Irham-Dipra/Automated-Maze-Solver_CSE-316/Assets/project_specs.md

Project Proposal Guidelines

The proposal presentation should include the following sections:

1. Motivation

* Clearly describe the problem your project will solve.
* Explain why the problem is important.
* State why your group selected this project.
* List the main objectives of the project.

2. Equipment

Provide a list of the required:

* Hardware components
* Software or development tools

Briefly mention the purpose of each major component.

3. System Design

* Provide a clear block diagram showing how the components are connected.
* Briefly explain the role of each component.
* Mention the important ATmega32 pins or interfaces to be used.

4. Role of the ATmega32

Clearly explain:

* What tasks the ATmega32 will perform.
* Which features will be used, such as GPIO, ADC, timers, PWM, interrupts, UART, SPI, or I²C.

The ATmega32 must perform a significant role in the project.

5. Implementation Plan

* Describe the expected outcome of the project.
* Divide the work into two development stages - project update 1 and final.
* Mention the main milestones and dependencies.
* Specify the responsibilities of each group member.

6. Use of Other Controllers — Optional

If another controller, such as an ESP32, Arduino, or Raspberry Pi, is used, explain:

* Why it is required.
* What tasks it will perform.
* How it will communicate with the ATmega32.

7. Testing and Success Criteria

* Explain how the system will be tested.
* Define measurable criteria for project success.
* Separate the essential features from optional features.

8. Challenges and Future Scope

* Identify possible technical or hardware-related challenges.
* Briefly discuss possible future improvements.
