Irham-Dipra/Automated-Maze-Solver_CSE-316/Assets/connections.md

# Connections

### Logic Power (Breadboard & MCUs)
*   Battery Pack 1 (Logic) -> Buck Converter IN
*   Buck Converter (5V) OUT+ -> Breadboard Power 1 & 2 (5V Rail)
*   Buck Converter (5V) OUT- -> Breadboard Gnd 1 & 2 (Common Gnd)

### Motor Power (High Current)
*   Battery Pack 2 (7.4V) positive -> Rocker Switch (Terminal 1)
*   Rocker Switch (Terminal 2) -> Motor drive 12V
*   Battery Pack 2 (7.4V) negative -> Motor drive GND
*   **CRITICAL:** Motor drive GND -> Breadboard Gnd 2 (Common ground required for PWM logic!)
*   *Note: Motor Driver 5V output is NO LONGER connected to the breadboard.*

## Capacitors (Noise Filtering)
*   1000µF Capacitor -> Across vin and GND of ESP32
*   100nF Capacitor -> Across ESP32 VIN and GND
*   100nF Capacitor -> Across ATmega32 VCC and GND

## Motor Driver Connections

*   Out1 - Left Motor top
*   Out2 - Left Motor bottom
*   Out3 - Right Motor top
*   Out4 - Right Motor bottom

*   IN1 - Atmega PB0 (1)
*   IN2 - Atmega PB1 (2)
*   IN3 - Atmega PB2 (3)
*   IN4 - Atmega PB4 (5)

*   ENA - Atmega PD5 (19)
*   ENB - Atmega PD4 (18)

## Atmega connections

*   VCC (Pin 10) - power 1
*   GND (Pin 11) - Gnd 1

*   AVCC (Pin 30) - power 2
*   GND  (Pin 31) - Gnd 2

## ESP

*   VIN - Power 2
*   ESP Gnd 1 - Gnd 1

## Logic Level Shifter (UART Bridge & 3.3V Sensor Power)

*   HV - Power 1 (ATmega 5V)
*   LV - ESP32 3V3 Pin (Creates the 3.3V Breadboard rail that powers all sensors)
*   GND (both) - Gnd 1 / Gnd 2
*   LV1 - ESP32 TX2 (Pin 24)
*   HV1 - ATmega RXD (PD0 / Pin 14)

## I2C Sensors (3x VL53L0X ToF & MPU6050 Gyro)

### Power (Shared by all sensors)
*   VIN / VCC - 3.3V Breadboard rail (from LV pin of Level Shifter / ESP32 3V3)
*   GND - Common Ground (Breadboard Gnd)

### I2C Bus (Shared parallel connection for all sensors)
*   SDA - ESP32 Pin 21
*   SCL - ESP32 Pin 22

### ToF XSHUT (Unique pin for each ToF sensor)
*   Front ToF XSHUT - ESP32 Pin 19
*   Left ToF XSHUT - ESP32 Pin 18
*   Right ToF XSHUT - ESP32 Pin 4
