Irham-Dipra/Automated-Maze-Solver_CSE-316/project proposal/presentation.pdf

## Automated Maze Solver


CSE 316: Microcontroller and Microprocessor Sessional

Group members:
Irham Dipra (2205068)
Priyanjan Das Anabil (2205079) Aroni Ananya (2205087)

Motivation

Motivation

## The project solves the challenge of an autonomous

## robot entering an unknown maze without simply

following a pre-drawn line.

Motivation

## It demonstrates the physical application of

## embedded algorithms, spatial mapping, and graph

traversal over basic reactive control.

Motivation

## This project leverages the group’s strong software foundation in algorithms (like BFS and Flood Fill)

## and data structures, applying them to a complex

physical constraint.

Motivation

## The robot must map the maze, remember visited

## cells, calculate the shortest exit path, and return to

the start.

Equipments & Roles


## ATmega32 Dev Board:

Main low-level microcontroller for hardware interrupts and motor driving.

Equipments & Roles


## ESP32 DevKit V1:

Coprocessor responsible for processing sensor arrays and executing pathfinding algorithms.

Equipments & Roles


## L298N Motor Driver:

Controls the voltage and direction of the chassis motors based on microcontroller signals.

Equipments & Roles


## 2WD Robot Chassis Kit:

Provides the physical movement platform, critically requiring included wheel encoder discs.

Equipments & Roles


## 3x VL53L0X ToF Sensors:

High-precision time-of-flight sensors to detect walls on the front, left, and right sides.

Equipments & Roles


## 18650 Batteries &

## Regulators:

Provides reliable portable power for the motors and distinct logic levels for the microcontrollers.

System Design

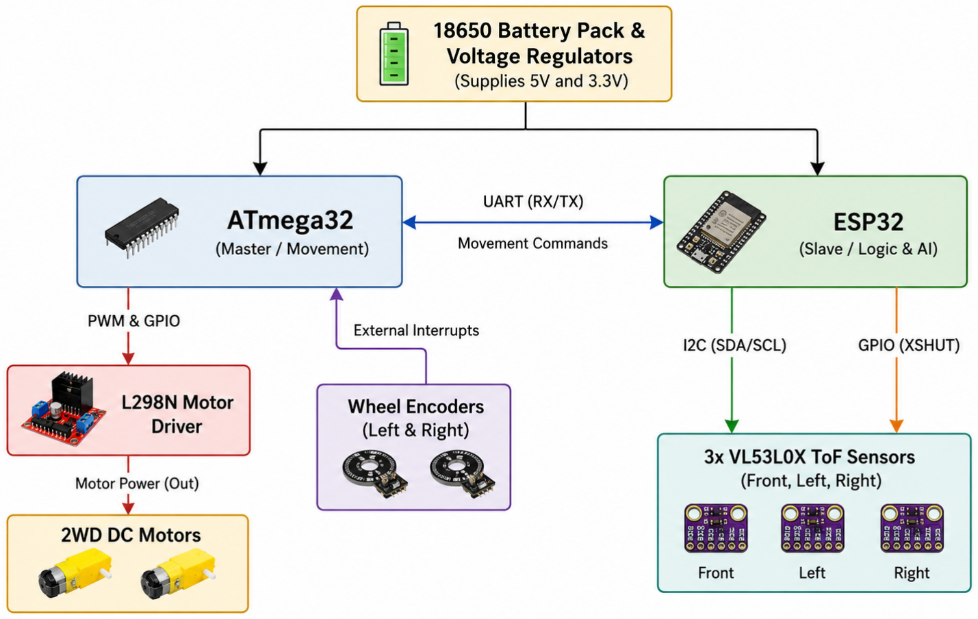
[picture p10: figure]

The system uses a master-slave configuration between the ATmega32 and the ESP32.

System Design

The ATmega32 is wired directly to the L298N motor driver and reads the wheel encoders.

System Design

The ESP32 interfaces with the three VL53L0X Time-of-Flight sensors via the I2C bus.

System Design

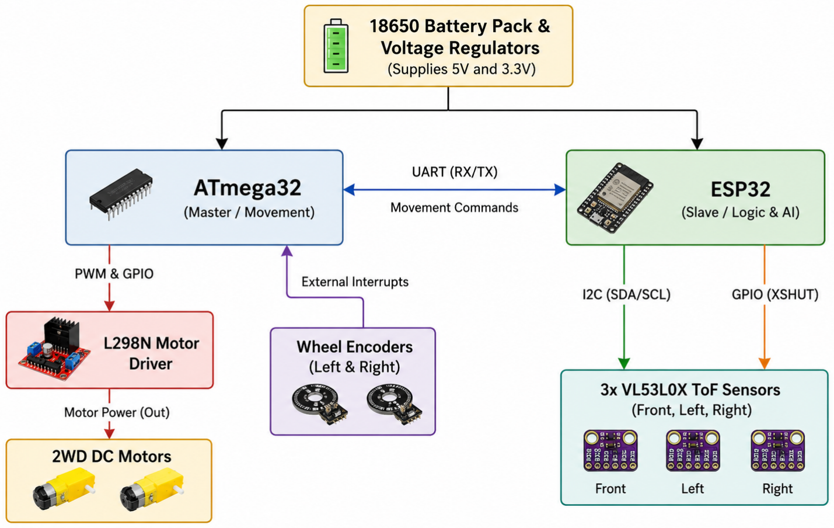
[picture p11: figure]

The ESP32 calculates movement logic and sends high-level commands (e.g., ”Move Forward 1 cell”) to the ATmega32 over a UART serial connection.

System Design

Important ATmega32 Interfaces Used:

UART (RX/TX Pins): Used to establish serial communication with the ESP32 to receive navigation commands.

System Design

Important ATmega32 Interfaces Used:

External Interrupt Pins (INT0 / INT1): Used to read the rapid pulse signals generated by the left and right wheel encoders to track distance.

System Design

Important ATmega32 Interfaces Used:

PWM Channels: Used to send variable voltage signals to the L298N driver, allowing for dynamic motor speed control via a PID algorithm.

System Design

Important ATmega32 Interfaces Used:

Standard GPIO Pins: Used to send basic HIGH/LOW logic to the L298N driver to control the forward and reverse direction of the motors.

Role of the ATmega32

- Primary Tasks:

Role of the ATmega32

- Primary Tasks:
- Dedicated real-time motion controller (translates ESP32 commands to motor timings).

Role of the ATmega32

- Primary Tasks:
- Dedicated real-time motion controller (translates ESP32 commands to motor timings).
- Executes continuous PID algorithm for straight driving and exact 90◦
turns.

Role of the ATmega32

- Primary Tasks:
- Dedicated real-time motion controller (translates ESP32 commands to motor timings).
- Executes continuous PID algorithm for straight driving and exact 90◦
turns.
- Hardware Features Utilized:

Role of the ATmega32

- Primary Tasks:
- Dedicated real-time motion controller (translates ESP32 commands to motor timings).
- Executes continuous PID algorithm for straight driving and exact 90◦
turns.
- Hardware Features Utilized:
- INT0/INT1: Read encoders for real-time distance tracking.

Role of the ATmega32

- Primary Tasks:
- Dedicated real-time motion controller (translates ESP32 commands to motor timings).
- Executes continuous PID algorithm for straight driving and exact 90◦
turns.
- Hardware Features Utilized:
- INT0/INT1: Read encoders for real-time distance tracking.
- Timers & PWM: Dynamic motor speed adjustments via PID.

Role of the ATmega32

- Primary Tasks:
- Dedicated real-time motion controller (translates ESP32 commands to motor timings).
- Executes continuous PID algorithm for straight driving and exact 90◦
turns.
- Hardware Features Utilized:
- INT0/INT1: Read encoders for real-time distance tracking.
- Timers & PWM: Dynamic motor speed adjustments via PID.
- UART & GPIO: Receive navigation commands and dictate

motor directions.

Use of Other Controllers (ESP32)

- Memory Constraint: The ATmega32 only has 2KB of

SRAM, which severely limits its ability to store complex maze arrays while handling heavy real-time motor control.

Use of Other Controllers (ESP32)

- Memory Constraint: The ATmega32 only has 2KB of

SRAM, which severely limits its ability to store complex maze arrays while handling heavy real-time motor control.
- Tasks: The ESP32 handles the heavy lifting of the Flood Fill

algorithm, tracks the state of the 256 cells, and manages the dynamic addressing sequence for the I2C sensors.

Use of Other Controllers (ESP32)

- Memory Constraint: The ATmega32 only has 2KB of

SRAM, which severely limits its ability to store complex maze arrays while handling heavy real-time motor control.
- Tasks: The ESP32 handles the heavy lifting of the Flood Fill

algorithm, tracks the state of the 256 cells, and manages the dynamic addressing sequence for the I2C sensors.
- Communication: It acts as the ”brain,” sending simplified

directional commands to the ATmega32 over UART.

Implementation Plan: Expected Outcome

- Expected Outcome: A fully autonomous robot capable of

navigating a 16 × 16 maze grid, mapping dead ends, and calculating the fastest route.

Implementation Plan: Project Updates

- Project Update 1 (Weeks 1-2):

Implementation Plan: Project Updates

- Project Update 1 (Weeks 1-2):
- Complete chassis assembly.

Implementation Plan: Project Updates

- Project Update 1 (Weeks 1-2):
- Complete chassis assembly.
- Establish PC simulation of the Flood Fill algorithm.

Implementation Plan: Project Updates

- Project Update 1 (Weeks 1-2):
- Complete chassis assembly.
- Establish PC simulation of the Flood Fill algorithm.
- Finalize the ATmega32 PID controller so the robot can drive in a perfectly straight line for 1 meter.

Implementation Plan: Project Updates

- Project Update 1 (Weeks 1-2):
- Complete chassis assembly.
- Establish PC simulation of the Flood Fill algorithm.
- Finalize the ATmega32 PID controller so the robot can drive in a perfectly straight line for 1 meter.
- Project Update 2 (Weeks 3-5):

Implementation Plan: Project Updates

- Project Update 1 (Weeks 1-2):
- Complete chassis assembly.
- Establish PC simulation of the Flood Fill algorithm.
- Finalize the ATmega32 PID controller so the robot can drive in a perfectly straight line for 1 meter.
- Project Update 2 (Weeks 3-5):
- Integrate the ToF sensors with the ESP32.

Implementation Plan: Project Updates

- Project Update 1 (Weeks 1-2):
- Complete chassis assembly.
- Establish PC simulation of the Flood Fill algorithm.
- Finalize the ATmega32 PID controller so the robot can drive in a perfectly straight line for 1 meter.
- Project Update 2 (Weeks 3-5):
- Integrate the ToF sensors with the ESP32.
- Merge the mapping logic with the movement logic.

Implementation Plan: Project Updates

- Project Update 1 (Weeks 1-2):
- Complete chassis assembly.
- Establish PC simulation of the Flood Fill algorithm.
- Finalize the ATmega32 PID controller so the robot can drive in a perfectly straight line for 1 meter.
- Project Update 2 (Weeks 3-5):
- Integrate the ToF sensors with the ESP32.
- Merge the mapping logic with the movement logic.
- Finalize edge-case tuning for wall-drift correction.

Testing and Success Criteria

System Testing Methodology

- Phased Approach: System tested in 4 phases to isolate

hardware vs. algorithmic bugs.

Testing and Success Criteria

System Testing Methodology

- Phased Approach: System tested in 4 phases to isolate

hardware vs. algorithmic bugs.
- Phase 1 (Locomotion & PID): Test perfectly straight 1m driving and exact 90◦
turns using encoder counts.

Testing and Success Criteria

System Testing Methodology

- Phased Approach: System tested in 4 phases to isolate

hardware vs. algorithmic bugs.
- Phase 1 (Locomotion & PID): Test perfectly straight 1m driving and exact 90◦
turns using encoder counts.
- Phase 2 (Sensor & I2C Calibration): Verify XSHUT

addressing to prevent I2C conflicts and calibrate ToF distances.

Testing and Success Criteria

System Testing Methodology

- Phased Approach: System tested in 4 phases to isolate

hardware vs. algorithmic bugs.
- Phase 1 (Locomotion & PID): Test perfectly straight 1m driving and exact 90◦
turns using encoder counts.
- Phase 2 (Sensor & I2C Calibration): Verify XSHUT

addressing to prevent I2C conflicts and calibrate ToF distances.
- Phase 3 (Algorithm Simulation): Test Flood Fill algorithm

on a PC simulation (virtual 16 × 16 grid) before flashing the ESP32.

Testing and Success Criteria

System Testing Methodology

- Phased Approach: System tested in 4 phases to isolate

hardware vs. algorithmic bugs.
- Phase 1 (Locomotion & PID): Test perfectly straight 1m driving and exact 90◦
turns using encoder counts.
- Phase 2 (Sensor & I2C Calibration): Verify XSHUT

addressing to prevent I2C conflicts and calibrate ToF distances.
- Phase 3 (Algorithm Simulation): Test Flood Fill algorithm

on a PC simulation (virtual 16 × 16 grid) before flashing the ESP32.
- Phase 4 (Full Integration): Test hardware/software

synchronization in scaled-down physical mazes (e.g., 4 × 4,
8 × 8). | 9

Testing and Success Criteria

Measurable Criteria for Project Success

- Metric 1: PID Synchronization Error (EPID)

Testing and Success Criteria

Measurable Criteria for Project Success

- Metric 1: PID Synchronization Error (EPID)
- Ensures motors spin at identical rates without drifting.

Testing and Success Criteria

Measurable Criteria for Project Success

- Metric 1: PID Synchronization Error (EPID)
- Ensures motors spin at identical rates without drifting.
- Formula: EPID = |Cleft − Cright| (where C = encoder pulse counts).

Testing and Success Criteria

Measurable Criteria for Project Success

- Metric 1: PID Synchronization Error (EPID)
- Ensures motors spin at identical rates without drifting.
- Formula: EPID = |Cleft − Cright| (where C = encoder pulse counts).
- Success: Steady-state error must approach zero during a

straight-line traversal.

Testing and Success Criteria

Measurable Criteria for Project Success

- Metric 1: PID Synchronization Error (EPID)
- Ensures motors spin at identical rates without drifting.
- Formula: EPID = |Cleft − Cright| (where C = encoder pulse counts).
- Success: Steady-state error must approach zero during a

straight-line traversal.
- Metric 2: Algorithmic Path Efficiency (ηpath)

Testing and Success Criteria

Measurable Criteria for Project Success

- Metric 1: PID Synchronization Error (EPID)
- Ensures motors spin at identical rates without drifting.
- Formula: EPID = |Cleft − Cright| (where C = encoder pulse counts).
- Success: Steady-state error must approach zero during a

straight-line traversal.
- Metric 2: Algorithmic Path Efficiency (ηpath)
- Evaluates optimal path calculation after mapping.

Testing and Success Criteria

Measurable Criteria for Project Success

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

straight-line traversal.
- Metric 2: Algorithmic Path Efficiency (ηpath)
- Evaluates optimal path calculation after mapping.
- Formula: ηpath =

Soptimal

Straversed

(Optimal cells vs. actual cells traversed).

Testing and Success Criteria

Measurable Criteria for Project Success

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

straight-line traversal.
- Metric 2: Algorithmic Path Efficiency (ηpath)
- Evaluates optimal path calculation after mapping.
- Formula: ηpath =

Soptimal

Straversed

(Optimal cells vs. actual cells traversed).
- Success: Achieving ηpath = 1, proving Flood Fill found the

absolute shortest path.

Testing and Success Criteria

Separation of Features

- Essential Features (MVP):

Testing and Success Criteria

Separation of Features

- Essential Features (MVP):
- Maintain accurate digital (X, Y ) coordinates and heading in

memory.

Testing and Success Criteria

Separation of Features

- Essential Features (MVP):
- Maintain accurate digital (X, Y ) coordinates and heading in

memory.
- Autonomously map the maze and find the center in a single

pass.

Testing and Success Criteria

Separation of Features

- Essential Features (MVP):
- Maintain accurate digital (X, Y ) coordinates and heading in

memory.
- Autonomously map the maze and find the center in a single

pass.
- Execute stable continuous PID motor control to navigate

without crashing.

Testing and Success Criteria

Separation of Features

- Essential Features (MVP):
- Maintain accurate digital (X, Y ) coordinates and heading in

memory.
- Autonomously map the maze and find the center in a single

pass.
- Execute stable continuous PID motor control to navigate

without crashing.
- Optional Features (Stretch Goals):

Testing and Success Criteria

Separation of Features

- Essential Features (MVP):
- Maintain accurate digital (X, Y ) coordinates and heading in

memory.
- Autonomously map the maze and find the center in a single

pass.
- Execute stable continuous PID motor control to navigate

without crashing.
- Optional Features (Stretch Goals):
- The Speed Run: Return to the start and execute a

high-speed run through the optimal path.

Testing and Success Criteria

Separation of Features

- Essential Features (MVP):
- Maintain accurate digital (X, Y ) coordinates and heading in

memory.
- Autonomously map the maze and find the center in a single

pass.
- Execute stable continuous PID motor control to navigate

without crashing.
- Optional Features (Stretch Goals):
- The Speed Run: Return to the start and execute a

high-speed run through the optimal path.
- Live Wi-Fi Telemetry: Broadcast the internal maze map in

real-time to a laptop dashboard.

Challenges and Future Scope

Technical and Hardware-Related Challenges

- Wheel Slip & Trajectory Drift:

Challenges and Future Scope

Technical and Hardware-Related Challenges

- Wheel Slip & Trajectory Drift:
- Physical motors never spin at perfectly identical speeds.

Challenges and Future Scope

Technical and Hardware-Related Challenges

- Wheel Slip & Trajectory Drift:
- Physical motors never spin at perfectly identical speeds.
- Solution: Highly tuned PID control using wheel encoders to constantly correct drift.

Challenges and Future Scope

Technical and Hardware-Related Challenges

- Wheel Slip & Trajectory Drift:
- Physical motors never spin at perfectly identical speeds.
- Solution: Highly tuned PID control using wheel encoders to constantly correct drift.
- I2C Address Conflicts:

Challenges and Future Scope

Technical and Hardware-Related Challenges

- Wheel Slip & Trajectory Drift:
- Physical motors never spin at perfectly identical speeds.
- Solution: Highly tuned PID control using wheel encoders to constantly correct drift.
- I2C Address Conflicts:
- All three VL53L0X sensors share the same default I2C address.

Challenges and Future Scope

Technical and Hardware-Related Challenges

- Wheel Slip & Trajectory Drift:
- Physical motors never spin at perfectly identical speeds.
- Solution: Highly tuned PID control using wheel encoders to constantly correct drift.
- I2C Address Conflicts:
- All three VL53L0X sensors share the same default I2C address.
- Solution: Sequentially wake sensors via XSHUT pins and

dynamically assign unique addresses.

Challenges and Future Scope

Technical and Hardware-Related Challenges

- Wheel Slip & Trajectory Drift:
- Physical motors never spin at perfectly identical speeds.
- Solution: Highly tuned PID control using wheel encoders to constantly correct drift.
- I2C Address Conflicts:
- All three VL53L0X sensors share the same default I2C address.
- Solution: Sequentially wake sensors via XSHUT pins and

dynamically assign unique addresses.
- ATmega32 Memory Limits (2KB SRAM):

Challenges and Future Scope

Technical and Hardware-Related Challenges

- Wheel Slip & Trajectory Drift:
- Physical motors never spin at perfectly identical speeds.
- Solution: Highly tuned PID control using wheel encoders to constantly correct drift.
- I2C Address Conflicts:
- All three VL53L0X sensors share the same default I2C address.
- Solution: Sequentially wake sensors via XSHUT pins and

dynamically assign unique addresses.
- ATmega32 Memory Limits (2KB SRAM):
- High risk of exhausting memory when storing maze states and

processing interrupts.

Challenges and Future Scope

Technical and Hardware-Related Challenges

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

dynamically assign unique addresses.
- ATmega32 Memory Limits (2KB SRAM):
- High risk of exhausting memory when storing maze states and

processing interrupts.
- Solution: Use efficient bitwise operations and offload Flood Fill logic to the ESP32.

Challenges and Future Scope

Future Scope and Improvements

- Live Wi-Fi Telemetry (Dashboard):

Challenges and Future Scope

Future Scope and Improvements

- Live Wi-Fi Telemetry (Dashboard):
- Broadcast the ESP32’s internal maze map over Wi-Fi.

Challenges and Future Scope

Future Scope and Improvements

- Live Wi-Fi Telemetry (Dashboard):
- Broadcast the ESP32’s internal maze map over Wi-Fi.
- Visualize robot coordinates and walls in real-time on a React/Node.js frontend.

Challenges and Future Scope

Future Scope and Improvements

- Live Wi-Fi Telemetry (Dashboard):
- Broadcast the ESP32’s internal maze map over Wi-Fi.
- Visualize robot coordinates and walls in real-time on a React/Node.js frontend.
- The Optimal Speed Run:

Challenges and Future Scope

Future Scope and Improvements

- Live Wi-Fi Telemetry (Dashboard):
- Broadcast the ESP32’s internal maze map over Wi-Fi.
- Visualize robot coordinates and walls in real-time on a React/Node.js frontend.
- The Optimal Speed Run:
- Expand the software to a complete multi-pass solver.

Challenges and Future Scope

Future Scope and Improvements

- Live Wi-Fi Telemetry (Dashboard):
- Broadcast the ESP32’s internal maze map over Wi-Fi.
- Visualize robot coordinates and walls in real-time on a React/Node.js frontend.
- The Optimal Speed Run:
- Expand the software to a complete multi-pass solver.
- After mapping, return to start and execute a high-speed run

through the calculated shortest route.

Challenges and Future Scope

Future Scope and Improvements

- Live Wi-Fi Telemetry (Dashboard):
- Broadcast the ESP32’s internal maze map over Wi-Fi.
- Visualize robot coordinates and walls in real-time on a React/Node.js frontend.
- The Optimal Speed Run:
- Expand the software to a complete multi-pass solver.
- After mapping, return to start and execute a high-speed run

through the calculated shortest route.
- Sensor Fusion (IMU Integration):

Challenges and Future Scope

Future Scope and Improvements

- Live Wi-Fi Telemetry (Dashboard):
- Broadcast the ESP32’s internal maze map over Wi-Fi.
- Visualize robot coordinates and walls in real-time on a React/Node.js frontend.
- The Optimal Speed Run:
- Expand the software to a complete multi-pass solver.
- After mapping, return to start and execute a high-speed run

through the calculated shortest route.
- Sensor Fusion (IMU Integration):
- Integrate an MPU6050 (Accelerometer & Gyroscope).

Challenges and Future Scope

Future Scope and Improvements

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

through the calculated shortest route.
- Sensor Fusion (IMU Integration):
- Integrate an MPU6050 (Accelerometer & Gyroscope).
- Fuse gyro data with wheel encoders for flawless straight headings and exactly 90◦
turns.
