Irham-Dipra/Automated-Maze-Solver_CSE-316/bluetooth_logs/test4.txt

07:37:05.783 Connecting to Maze_Calibrator ...
07:37:07.105 Connected
07:37:08.311 
07:37:08.311 === HARDWARE CALIBRATION MENU ===
07:37:08.320 Commands:
07:37:08.320   BL:150  -> Base Left Speed
07:37:08.320   BR:150  -> Base Right Speed
07:37:08.320   TR:400  -> Turn Right Delay
07:37:08.320   TL:400  -> Turn Left Delay
07:37:08.320   TU:800  -> U-Turn Delay
07:37:08.320   FD:260  -> Front Brake Distance
07:37:08.320   START   -> Begin driving
07:37:08.320   STOP    -> Halt the car
07:37:08.320 =================================
07:37:08.320 
07:37:08.320 Current: BL=128 | BR=145 | TR=390 | TL=390 | TU=780 | FD=260
07:37:23.512 BL:255
07:37:23.603 
07:37:23.603 Current: BL=255 | BR=145 | TR=390 | TL=390 | TU=780 | FD=260
07:37:31.963 BR:80
07:37:32.199 
07:37:32.199 Current: BL=255 | BR=80 | TR=390 | TL=390 | TU=780 | FD=260
07:37:43.603 FD:280
07:37:48.060 FD:280
07:37:49.326 FD:280
07:37:53.836 START
07:37:53.895 
07:37:53.895 >>> STARTING BLIND CALIBRATION DRIVE <<<
07:37:54.035 SOFT START: Ramping up power to prevent Brown-Out Resets...
07:37:54.271 BLIND DRIVE: [F:8190 L:117 R:120]
07:37:54.440 BLIND DRIVE: [F:8190 L:98 R:189]
07:37:54.598 
07:37:54.598 CORNER DETECTED! [F:78 L:78 R:8190]
07:37:56.619 Blind Turning Right...
07:37:56.999 Turn complete! Check the physical angle!
07:37:59.541 SOFT START: Ramping up power to prevent Brown-Out Resets...
07:37:59.542 BLIND DRIVE: [F:8190 L:151 R:178]
07:37:59.667 BLIND DRIVE: [F:8190 L:143 R:116]
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
07:39:14.421 
07:39:14.421 CORNER DETECTED! [F:43 L:8190 R:8190]
07:39:16.174 STOP
07:39:16.255 Blind Turning Right...
07:39:16.649 Turn complete! Check the physical angle!
07:39:18.706 
07:39:18.706 >>> SYSTEM HALTED! You may now recalibrate. Send 'START' to resume. <<<
