Irham-Dipra/Automated-Maze-Solver_CSE-316/bluetooth_logs/test5.txt

IND DRIVE: [F:8190 L:117 R:120]
07:54:37.098 BLIND DRIVE: [F:8190 L:117 R:134]
07:54:37.274 BLIND DRIVE: [F:8190 L:117 R:125]
07:54:37.441 BLIND DRIVE: [F:8190 L:122 R:122]
07:54:37.606 BLIND DRIVE: [F:8190 L:137 R:105]
07:54:37.796 BLIND DRIVE: [F:8190 L:154 R:91]
07:54:37.957 BLIND DRIVE: [F:8190 L:177 R:75]
07:54:38.129 BLIND DRIVE: [F:8190 L:206 R:48]
07:54:38.408 BLIND DRIVE: [F:8190 L:8190 R:33]
07:54:38.492 BLIND DRIVE: [F:8190 L:8190 R:27]
07:54:38.648 BLIND DRIVE: [F:8190 L:8190 R:33]
07:54:38.827 BLIND DRIVE: [F:8190 L:8190 R:42]
07:54:38.994 BLIND DRIVE: [F:8190 L:237 R:8190]
07:54:39.157 BLIND DRIVE: [F:8190 L:232 R:19]
07:54:39.337 BLIND DRIVE: [F:8190 L:240 R:36]
07:54:39.503 
07:54:39.503 CORNER DETECTED! [F:148 L:239 R:33]
07:54:41.528 Blind U-Turn...
07:54:42.280 Turn complete! Check the physical angle!
07:54:44.470 
07:54:44.470 CORNER DETECTED! [F:84 L:265 R:49]
07:54:44.854 STOP
07:54:46.465 Blind Turning Left...
07:54:46.851 Turn complete! Check the physical angle!
07:54:48.923 
07:54:48.923 >>> SYSTEM HALTED! You may now recalibrate. Send 'START' to resume. <<<
07:55:03.677 BL:250
07:55:03.902 
07:55:03.902 Current: BL=250 | BR=10 | TR=390 | TL=390 | TU=780 | FD=360
07:55:07.244 START
07:55:07.305 
07:55:07.305 >>> RESUMING DRIVE WITH NEW CALIBRATION! <<<
07:55:07.420 SOFT START: Ramping up power to prevent Brown-Out Resets...
07:55:07.668 BLIND DRIVE: [F:8190 L:121 R:118]
07:55:07.939 BLIND DRIVE: [F:8190 L:115 R:134]
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
07:58:08.177 
07:58:08.177 CORNER DETECTED! [F:48 L:203 R:8190]
07:58:09.101 STOP
07:58:09.729 Blind Turning Right...
07:58:10.098 Turn complete! Check the physical angle!
07:58:11.518 STOP
07:58:12.158 
07:58:12.158 >>> SYSTEM HALTED! You may now recalibrate. Send 'START' to resume. <<<
