Irham-Dipra/Automated-Maze-Solver_CSE-316/bluetooth_logs/test6.txt

01:41:23.267 Connection lost
01:41:27.479 Connecting to Maze_Robot_Dipra ...
01:41:29.819 Connected
01:41:31.311 
01:41:31.311 === PHASE 3 (PID) CALIBRATION MENU ===
01:41:31.311   BL:180  -> Base Left Speed
01:41:31.311   BR:10   -> Base Right Speed
01:41:31.311   FD:260  -> Front Brake Distance
01:41:31.311   P:0.3   -> PID P-Gain
01:41:31.311   D:0.2   -> PID D-Gain
01:41:31.311   START   -> Begin driving
01:41:31.311   STOP    -> Halt the car (on the fly)
01:41:31.311 ======================================
01:41:31.311 
01:41:31.311 Current: BL=180 | BR=10 | TR=390 | TL=390 | TU=780 | FD=260 | P=0.20 | D=0.10 | I=0.00
01:41:42.482 BL:220
01:41:42.636 
01:41:42.636 Current: BL=220 | BR=10 | TR=390 | TL=390 | TU=780 | FD=260 | P=0.20 | D=0.10 | I=0.00
01:41:47.748 BL:220FD:300
01:41:47.932 
01:41:47.932 Current: BL=220 | BR=10 | TR=390 | TL=390 | TU=780 | FD=260 | P=0.20 | D=0.10 | I=0.00
01:41:54.122 FD:300
01:41:54.628 
01:41:54.628 Current: BL=220 | BR=10 | TR=390 | TL=390 | TU=780 | FD=300 | P=0.20 | D=0.10 | I=0.00
01:42:00.997 TR:350
01:42:40.638 P:1.5
01:42:40.733 
01:42:40.733 Current: BL=220 | BR=10 | TR=390 | TL=390 | TU=780 | FD=300 | P=1.50 | D=0.10 | I=0.00
01:42:45.822 START
01:42:46.007 
01:42:46.007 >>> STARTING PID MAZE SOLVER! <<<
01:42:46.166 PID -> Err:5 Adj:8 [L:84 R:7]
01:42:46.378 PID -> Err:0 Adj:0 [L:110 R:5]
01:42:46.497 PID -> Err:-24 Adj:-38 [L:153 R:0]
01:42:46.675 PID -> Err:-57 Adj:-88 [L:178 R:0]
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
01:43:25.022 PID -> Err:107 Adj:160 [L:60 R:170]
01:43:25.195 PID -> Err:104 Adj:155 [L:65 R:165]
01:43:25.276 STOP
01:43:25.353 PID -> Err:103 Adj:154 [L:66 R:164]
01:43:25.411 
01:43:25.411 >>> SYSTEM HALTED! You may now recalibrate. Send 'START' to resume. <<<
