Irham-Dipra/Automated-Maze-Solver_CSE-316/bluetooth_logs/test8.txt

96 PID -> Err:-32 Adj:-25 (Steering Left) [PWM_L:255 PWM_R:0]
02:53:24.652 PID -> Err:-31 Adj:-24 (Steering Left) [PWM_L:255 PWM_R:0]
02:53:24.824 PID -> Err:-31 Adj:-24 (Steering Left) [PWM_L:255 PWM_R:0]
02:53:25.006 PID -> Err:-32 Adj:-25 (Steering Left) [PWM_L:255 PWM_R:0]
02:53:25.186 PID -> Err:-30 Adj:-23 (Steering Left) [PWM_L:255 PWM_R:0]
02:53:25.347 PID -> Err:-32 Adj:-25 (Steering Left) [PWM_L:255 PWM_R:0]
02:53:25.538 PID -> Err:-32 Adj:-25 (Steering Left) [PWM_L:255 PWM_R:0]
02:53:27.269 PID -> Err:-31 Adj:-24 (Steering Left) [PWM_L:255 PWM_R:0]
02:53:27.269 PID -> Err:-31 Adj:-24 (Steering Left) [PWM_L:255 PWM_R:0]
02:53:27.272 PID -> Err:-31 Adj:-24 (Steering Left) [PWM_L:255 PWM_R:0]
02:53:27.277 PID -> Err:-30 Adj:-23 (Steering Left) [PWM_L:255 PWM_R:0]
02:53:27.282 PID -> Err:-32 Adj:-25 (Steering Left) [PWM_L:255 PWM_R:0]
02:53:27.287 PID -> Err:-34 Adj:-27 (Steering Left) [PWM_L:255 PWM_R:0]
02:53:27.317 PID -> Err:-31 Adj:-24 (Steering Left) [PWM_L:255 PWM_R:0]
02:53:27.320 PID -> Err:-33 Adj:-26 (Steering Left) [PWM_L:255 PWM_R:0]
02:53:27.320 PID -> Err:-30 Adj:-23 (Steering Left) [PWM_L:255 PWM_R:0]
02:53:27.320 PID -> Err:-33 Adj:-26 (Steering Left) [PWM_L:255 PWM_R:0]
02:53:27.414 PID -> Err:-33 Adj:-26 (Steering Left) [PWM_L:255 PWM_R:0]
02:53:27.582 PID -> Err:-32 Adj:-25 (Steering Left) [PWM_L:255 PWM_R:0]
02:53:27.765 PID -> Err:-31 Adj:-24 (Steering Left) [PWM_L:255 PWM_R:0]
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
02:53:45.004 PID -> Err:-32 Adj:-25 (Steering Left) [PWM_L:255 PWM_R:0]
02:53:45.163 PID -> Err:-30 Adj:-23 (Steering Left) [PWM_L:255 PWM_R:0]
02:53:45.343 PID -> Err:-32 Adj:-25 (Steering Left) [PWM_L:255 PWM_R:0]
02:53:45.509 PID -> Err:-33 Adj:-26 (Steering Left) [PWM_L:255 PWM_R:0]
02:53:45.743 PID -> Err:-31 Adj:-24 (Steering Left) [PWM_L:255 PWM_R:0]
02:53:45.875 PID -> Err:-30 Adj:-23 (Steering Left) [PWM_L:255 PWM_R:0]
02:53:46.025 PID -> Err:-35 Adj:-28 (Steering Left) [PWM_L:255 PWM_R:0]
02:53:46.194 PID -> Err:-32 Adj:-25 (Steering Left) [PWM_L:255 PWM_R:0]
02:53:46.379 PID -> Err:-32 Adj:-25 (Steering Left) [PWM_L:255 PWM_R:0]
02:53:46.536 PID -> Err:-32 Adj:-25 (Steering Left) [PWM_L:255 PWM_R:0]
02:53:46.721 PID -> Err:-33 Adj:-26 (Steering Left) [PWM_L:255 PWM_R:0]
02:53:46.899 PID -> Err:-32 Adj:-25 (Steering Left) [PWM_L:255 PWM_R:0]
02:53:47.064 PID -> Err:-31 Adj:-24 (Steering Left) [PWM_L:255 PWM_R:0]
02:53:47.236 PID -> Err:0 Adj:3 (Straight) [PWM_L:242 PWM_R:18]
02:53:47.412 MAZE: Wall Ahead! STOPPING... [F:173 L:8190 R:8190]
02:53:49.401 MAZE: Right is open! Turn RIGHT. [L:8190 R:8190]
02:53:49.959 ALIGN: Radar Sweep searching for absolute peak...
02:53:50.251   [Sweep 1] Twitched L -> New F:8190
02:53:50.252 ALIGN: Max range limit reached! Locked at [F:8190]
02:53:57.150 Connection lost
