Irham-Dipra/Automated-Maze-Solver_CSE-316/cse316_project-main/code/main/i2c.h

#ifndef I2C_H
#define I2C_H
#include <stdint.h>

void    I2C_Init(void);
void    I2C_Start(void);
void    I2C_Stop(void);
void    I2C_Write(uint8_t data);
uint8_t I2C_ReadAck(void);
uint8_t I2C_ReadNack(void);
#endif
