Irham-Dipra/Automated-Maze-Solver_CSE-316/(commit log)

2026-09-28 Add Phase 5: gyro-stabilised maze solver (ESP32 + ATmega32)
    Replaces CurrentOnlySensorCode.ino and Phase3_ATmega_Slave.cpp, integrating
    the proven techniques from maheeCode into the existing dual-MCU hardware.
    Faults diagnosed from bluetooth_logs/ and fixed:
    - Unframed 3-byte UART protocol let a dropped byte resync onto a PWM value
    that equals a command letter ('R'=82, 'S'=83, 'F'=70 all sit inside the
    PWM range), turning a speed into a full-power pivot. Now framed with a
    sync byte and checksum; bad packets are dropped, never half-executed.
    - No failsafe: the slave held its last command forever, so an ESP32 brownout
    or a dropped Bluetooth link left the motors running. Slave now sto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
    [Phase5_ATmega_Slave.c, Phase5_ESP32_Brain.ino]
2026-09-28 Make STOP always work, and gate mode changes behind STOP/START
    STOP was unreachable for most of a run. pumpCommands() was called only from
    loop(); every blocking wait -- gyro calibration, the breakaway kick, and the
    whole turn routine -- called motorHeartbeat() alone, so an incoming STOP was
    not even read until the blocking section finished. A pivot plus its
    recalibration blocks for over ten seconds.
    - Add serviceWhileBusy() (heartbeat + pumpCommands) and call it from every
    blocking loop, so commands are read while the robot is busy.
    - Add a g_abort flag that STOP sets. The sweep, brake, settle, nudge,
    calibration and kick loops all poll it and bail out; an aborted pivot skips
    its rec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
    [Phase5_ESP32_Brain.ino]
2026-09-28 Fix the ToF near-wall latch jamming the front sensor after every pivot
    Diagnosed from the 14:18 bluetooth log, where the robot turned right into a
    completely open corridor immediately after its first pivot (PATH: R -> RR).
    The near-wall latch fed itself. On firing it wrote the synthetic
    TOF_TOO_CLOSE_MM (40) back into last_good; 40 is below TOF_NEAR_LATCH_MM
    (120), so every subsequent out-of-range reading re-armed the latch and wrote
    40 again. In an open corridor, where out-of-range IS the normal reading, the
    front sensor reported "wall touching me" permanently, front votes pinned at
    5/5, and the maze logic forced a turn at every junction. Only the flush after
    a turn ever cleared it. mahee'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
    [Phase5_ESP32_Brain.ino]
2026-09-28 Document the control law and every tunable parameter
    Adds a parameter reference to the Phase 5 README: what each telemetry field
    means, the exact order of operations inside driveTick() (wall centring ->
    emergency ramp -> PD -> yaw governor -> clamp -> stall-floor lift -> trim),
    and a table of every runtime key with its unit, default and meaning.
    The units matter and were not written down anywhere: KP is PWM counts per
    degree, KD is PWM counts per deg/s, and KW is degrees of heading target per
    millimetre of centring error. Without that, the three gains look
    interchangeable when they are not.
    Also records the sign conventions that everything downstream depends on:
    +Hdg is rotated left, +Corr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
2026-09-28 Derive junction geometry, and decelerate into the stop instead of coasting
    Two faults behind "we cannot find a front distance that works": one geometric,
    one dynamic. No single FD could have fixed either.
    GEOMETRY. CORRIDOR_HALF_MM was standing in for three different lengths that
    are not equal:
    CW/2 where the AXLE must sit to pivot into a side opening and come
    out centred
    (CW - RW)/2 what a SIDE sensor reads when centred -- smaller than CW/2 by
    half the chassis, and the correct centring reference
    CW/2 - AX what the FRONT sensor reads when the axle is on that
    centreline, i.e. the only correct place to park before a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
    [Phase5_ESP32_Brain.ino]
2026-09-28 Measure the side sensors separately from the chassis, and crawl on timed approaches
    Real chassis dimensions (length 230, front sensor 130 ahead of the axle, side
    sensors 105 apart and 70 further back) show two places where treating the side
    sensors as if they sat at the widest point, level with the front sensor, gives
    the wrong answer.
    Centring compared a side reading against (CW - RW)/2. The side sensors are
    inset 27.5 mm from the widest point, so a centred robot reads 147.5 mm where
    that formula predicts 120 mm -- a standing 27.5 mm bias whenever only one wall
    is visible. Centring now uses a measured sensor span SS: (CW - SS)/2.
    The approach travel after spotting a side opening used AX,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
    [Phase5_ESP32_Brain.ino]
2026-09-28 Ship the measured chassis and tuning values as defaults, and derive WE
    The chassis dimensions are now known rather than guessed, so they become the
    power-on defaults instead of placeholders: CW 400, RW 160, RL 230, AX 130,
    SS 105, SA 60. Likewise the tuning values that testing settled on: MN 95,
    BL 135, RT 120, KP 4.5, KD 0.35. Settings live in RAM and reset on every
    power cycle, so a correct default is the difference between a robot that works
    on boot and one that needs a dozen commands typed at it first. All remain
    changeable at runtime.
    WE joins FD in being derived rather than guessed, since it is pure arithmetic:
    WE = (CW-RW)/4 + (RW-SS)/2
    A centred chassis has (CW-RW)/2 of gap pe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
    [Phase5_ESP32_Brain.ino]
2026-09-28 Choose the turn at the junction, not on approach; stop turning back
    Four fixes from the 21:18/21:19 run, plus one safety gap.
    1. Pivots ignored LT/RT. motorPivot() sent the same raw PWM to both wheels,
    which only rotates in place if the motors match. With the right motor 20%
    down, the forward wheel out-pushes the reverse wheel: the chassis rotates
    AND creeps forward. Parked 65 mm off a wall, that creep jams the nose into
    it partway through the turn, which is the "achieved 5.7 deg TIMED OUT" in
    the log. Pivots now trim like driving does.
    2. The direction was chosen the instant a junction was first suspected -- up
    to FB away, at speed, side sensors still aimed at corridor w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
    [Phase5_ESP32_Brain.ino]
2026-09-28 Creep to the park point; hold the brake; make a failed sensor boot recoverable
    Braking distance and parking accuracy were being solved with one number, and
    they pull in opposite directions. FB has to be generous or a robot arriving
    down a long straight cannot shed its momentum before the wall. The same
    generous FB makes a robot that is already crawling -- one that has just
    finished a pivot a few hundred mm from an obstacle -- start its ramp at once
    and coast to a halt far short of the junction, then pivot from too far back
    and clip the corner.
    Separate them. Braking stops the robot wherever it stops; a new CREEPING state
    then closes the remaining gap in short measured pulses until the front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
    [Phase5_ESP32_Brain.ino]
2026-09-29 Never call a blocked front a clear corridor; stop the heading target thrashing
    Front crashes on the fast legs were not FB failing -- FB was working, and
    that is why 300 and 400 behaved identically. The log shows fv:5 from 280 mm
    onward, so the wall was detected the whole way in. The classifier threw the
    detection away.
    updateDebounce() applied the came-from block to the open counters but the
    dead-end test called tofOpen() directly. After a right turn, with a wall ahead
    and a wall to the left, the right still read open to the dead-end test (so
    cnt_deadend stayed 0) while the counters saw it closed. classify() then
    matched none of its seven cases and fell through to J_CORRIDOR -- "nothing
    her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
    [Phase5_ESP32_Brain.ino]
2026-09-29 Centre continuously, U-turn toward the room, and keep the logs on a PC
    Five things, from the test report.
    A PC monitor. tools/maze_monitor.py is a terminal for the same SPP link the
    phone app uses, except every line lands in tools/logs/ as it arrives. The line
    that explains a crash is always the one that just scrolled off a phone screen.
    Quitting sends STOP, so closing the monitor cannot leave the robot driving.
    Centring was not weak, it was slow. KW sets a heading TARGET, and lateral
    position is the integral of heading, so the loop settles with time constant
    1/(2*v*KW). At 0.020 deg/mm and 250 mm/s that is about six seconds -- a 1.1 m
    corridor is over in four, so the only correction ever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
    [Phase5_ESP32_Brain.ino, maze_monitor.py]
2026-09-29 Do not track the monitor's __pycache__
    Claude-Session: https://claude.ai/code/session_0137QqAALCP53KT6DzELrZzR
2026-09-29 Look for the name the firmware actually advertises
    The monitor's port detection and its instructions both said 'MazeBot'.
    SerialBT.begin() says 'MazeSolver_P5', so the auto-detect scored the real
    device no higher than any random USB-serial adapter.
    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
2026-09-29 Find the RFCOMM channel instead of assuming 1, and say what actually failed
    Connecting with --mac hardcoded channel 1 and surfaced every failure as a
    bare 'TimeoutError: timed out'.
    Nothing guarantees channel 1. The ESP32 stack picks a free channel when it
    registers the SPP record, so the port can land on 2 or 3 -- and the resulting
    error is indistinguishable from the robot being switched off. The channel now
    comes from an SDP browse, falling back to trying 1, 2 and 3.
    The error path was worse than the bug. A timeout on RFCOMM almost always
    means another client already holds the link, because the ESP32 serves exactly
    one at a time -- so the usual cause of 'timed out' is the phone app still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
    [maze_monitor.py]
2026-09-29 Point a timed-out socket at the bind fallback, and stop reading stdin ahead
    A direct AF_BLUETOOTH socket can time out against a device that l2ping
    reaches perfectly well and that 'rfcomm bind' then connects to first try --
    the two take different paths through bluez. The timeout diagnosis now says
    so and gives the bind commands, instead of listing only causes that the
    l2ping replies have already ruled out.
    Iterating sys.stdin reads ahead into a hidden buffer, which can hold a typed
    command back until the next line arrives -- on an interactive link that reads
    as the robot ignoring you. readline() hands each line over as it is entered,
    and also strips a CR so a command typed in a terminal that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
2026-09-29 Prove the robot is answering before calling the session connected
    The monitor printed '[connected to /dev/rfcomm0]' on the strength of open()
    returning. That is not evidence of anything: rfcomm bind creates the node
    whether or not the link ever comes up, and pyserial opens a tty non-blocking,
    so the open succeeds the instant the node exists. A session with no link
    behind it is indistinguishable from a working one -- commands echo, nothing
    comes back, and the first suspicion falls on the firmware.
    It now says 'opened', sends MENU (which the firmware answers unconditionally,
    even mid-run) and warns if nothing arrives in 4 s, naming the causes in the
    order worth checking: another client holdin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
2026-09-29 Record the straights, and add a speed run that follows the shortened route
    MODE:3 now writes an S when it passes a junction without turning, reduces the
    path at the exit and saves the result. MODE:4 drives that route.
    The reduction is dead-end elimination on the turn string -- no grid, no
    coordinates, no distances. A U means a dead end was entered and left, and the
    moves either side of it happened at the same junction, so the three collapse
    into one. Written as quarter turns (S=0 L=1 U=2 R=3) that is (a + 2 + b) mod
    4, which generates the entire nine-case LSRB table from one line rather than
    a hand-typed table. The test checks all nine against the table written out
    independently.
    The S is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
    [Phase5_ESP32_Brain.ino]
